isao-px/Abraxas_PCB/Fabrication/BOM_Abraxas_doable_2026-10-19.csv

ID | Name | Designator | Footprint | Quantity | Manufacturer Part | Manufacturer | Supplier | Supplier Part | Price | Pins | 3DModel | Contributor | JLCPCB Part Class | link
1 | 1kΩ | R1,R7,R33 | R0603 | 3 | FRC0603F1001TS | FOJAN(富捷) | LCSC | C2907002 | 0.002 | 2 | R0603 | lcsc | Extended Part | https://www.mouser.in/datasheet/2/447/PYu_RT_1_to_0_01_RoHS_L_11-1669912.pdf
2 | 220Ω | R2,R4,R5,R6,R13 | R0603 | 5 | FRC0603F2200TS | FOJAN(富捷) | LCSC | C2907014 | 0.002 | 2 | R0603 | lcsc | Extended Part | https://www.mouser.in/datasheet/2/447/PYu_RT_1_to_0_01_RoHS_L_11-1669912.pdf
3 | 510Ω | R9,R14 | R0603 | 2 | FRC0603F5100TS | FOJAN(富捷) | LCSC | C2907048 | 0.002 | 2 | R0603 | lcsc | Extended Part | https://www.mouser.in/datasheet/2/447/PYu_RT_1_to_0_01_RoHS_L_11-1669912.pdf
4 | 4.7kΩ | R10,R11 | R0603 | 2 | FRC0603F4701TS | FOJAN(富捷) | LCSC | C2907034 | 0.002 | 2 | R0603 | LCSC | Extended Part | https://www.mouser.in/datasheet/2/447/PYu_RT_1_to_0_01_RoHS_L_11-1669912.pdf
5 | 120Ω | R12 | R0603 | 1 | FRC0603F1200TS | FOJAN(富捷) | LCSC | C2906988 | 0.002 | 2 | R0603 | lcsc | Extended Part | https://www.mouser.in/datasheet/2/447/PYu_RT_1_to_0_01_RoHS_L_11-1669912.pdf
6 | KT-0603R | LED6,LED2,LED4,LED5,LED14,LED1,LED3 | LED-SMD_L1.6-W0.8-R-RD | 7 | KT-0603R | KENTO | LCSC | C2286 | 0.008 | 2 | LED0603_L1.6-W0.8-H0.6 | lcsc | Basic Part | https://item.szlcsc.com/347796.html
7 | 3.3kΩ | R8 | R0603 | 1 | FRC0603F3301TS | FOJAN(富捷) | LCSC | C2907023 | 0.002 | 2 | R0603 | lcsc | Extended Part | https://www.mouser.in/datasheet/2/447/PYu_RT_1_to_0_01_RoHS_L_11-1669912.pdf
8 | INFO_PINS | U15 | HDR-TH_8P-P2.54-V-F | 1 | BX-PM2.54-1-8PY | Bossie(博锡) | LCSC | C18078131 | 0.143 | 8 | HDR-TH_8P-P2.54-V-F | lcsc | Extended Part | https://item.szlcsc.com/760112.html
9 | KT-0603RG | LED13 | LED-SMD_4P-L1.6-W1.5_KT-0603RG | 1 | KT-0603RYG | KENTO | LCSC | C24477 | 0.027 | 4 | LED-ARRAY-SMD_4P-L1.6-W1.5-H0.6-P0.8 | lcsc | Extended Part | https://atta.szlcsc.com/upload/public/pdf/source/20240614/A37E0302B47AC53F7ED7BF75B5175F81.pdf
10 | NPN | Q11 | TO-92-3_L4.8-W3.7-P1.27-R-1 | 1 | BC547BBU | onsemi(安森美) | LCSC | C896669 | 0.155 | 3 | TO-92-3_L4.8-W3.7-P1.27-R-1 | LCSC | Extended Part | https://www.ti.com/cn/lit/ds/symlink/tlv431a.pdf?ts=1644846374370
11 | PNP | Q12 | TO-92-3_L4.9-W3.7-P1.27-L | 1 | BC557C | LGE(鲁光) | LCSC | C713618 | 0.048 | 3 | TO-92-3_L4.9-W3.7-P1.27-L | LCSC | Extended Part | https://atta.szlcsc.com/upload/public/pdf/source/20180629/C233232_99576441F8ED8E9074FB1575A6BE3592.PDF
12 | 51Ω | R35,R36 | R0603 | 2 | FRC0603F51R0TS | FOJAN(富捷) | LCSC | C2907050 | 0.002 | 2 | R0603 | LCSC | Extended Part | https://www.mouser.in/datasheet/2/447/PYu_RT_1_to_0_01_RoHS_L_11-1669912.pdf
13 | RS485/USB | U13 | HDR-TH_3P-P2.54-V-F | 1 | BX-PM2.54-1-3PY | Bossie(博锡) | LCSC | C18078126 | 0.095 | 3 | HDR2.54-F-LI-1X3P | lcsc | Extended Part | https://item.szlcsc.com/562471.html
14 | TS-1088-AR02016 | SW1,SW2 | SW-SMD_L3.9-W3.0-P4.45 | 2 | TS-1088-AR02016 | XUNPU(讯普) | LCSC | C720477 | 0.053 | 2 | SW-SMD_L3.9-W2.9-H2.0-LS4.8 | LCSC | Basic Part | https://item.szlcsc.com/457636.html
15 | 1.25A/2.5A | F1 | F1812 | 1 | MINISMDC125F/16-2 | Littelfuse(美国力特) | LCSC | C15156 | 0.309 | 2 | F1812_L4.5-W3.2-H1.0 | LCSC | Extended Part | https://item.szlcsc.com/343302.html
16 | SS12D10G5 | U12,U14,U11 | SW-TH_SHOU-HAN_SS12D10G4 | 3 | SS12D10G5 | SHOU HAN(首韩) | LCSC | C7431054 | 0.177 | 3 | SW-TH_SHOU-HAN_SS12D10G4 | lcsc | Extended Part | https://atta.szlcsc.com/upload/public/pdf/source/20210820/80D1704BBF3FCEE0435FCAA54C61E0A3.pdf
17 | 1000uF | C1 | CAP-TH_BD8.0-P3.50-D0.6-FD | 1 | ULR108M1AF1ACB | MAN YUE(万裕科技) | LCSC | C248439 | 0.251 | 2 | CAP-TH_D8.0-H8.0-P3.50 | LCSC | Extended Part | https://atta.szlcsc.com/upload/public/pdf/source/20151029/1457707523808.pdf
18 | SHIM1 | U8 | HDR-TH_12P-P2.54-V-F-R2-C6-S2.54 | 1 | BX-PM2.54-2-6PY | Bossie(博锡) | LCSC | C18078145 | 0.184 | 12 | HDR-TH_12P-P2.54-F-LI-2X6P | lcsc | Extended Part | https://item.szlcsc.com/562476.html
19 | SHIM2 | U9 | HDR-TH_2P-P2.54-V-F-1 | 1 | BX-PM2.54-1-2PY | Bossie(博锡) | LCSC | C18078125 | 0.095 | 2 | HDR2.54-F-LI-1X2P | lcsc | Extended Part | https://item.szlcsc.com/225782.html
20 | PB- | U7 | HDR-TH_2P-P2.54-V-F-1 | 1 | BX-PM2.54-1-2PY | Bossie(博锡) | LCSC | C18078125 | 0.095 | 2 | HDR2.54-F-LI-1X2P | lcsc | Extended Part | https://item.szlcsc.com/225782.html
21 | PB+ | U10 | HDR-TH_2P-P2.54-V-F-1 | 1 | BX-PM2.54-1-2PY | Bossie(博锡) | LCSC | C18078125 | 0.095 | 2 | HDR2.54-F-LI-1X2P | lcsc | Extended Part | https://item.szlcsc.com/225782.html
22 | GPS | U4 | HDR-TH_9P-P2.54-V-F-4 | 1 | BX-PM2.54-1-9PY | Bossie(博锡) | LCSC | C49326044 | 0.221 | 9 | HDR-TH_9P-P2.54-V-F-4 | lcsc | Extended Part | https://multimedia.3m.com/mws/media/22500O/3mtm-boardmount-skt-100-100x-100strt-sldr-tails-ts0815.pdf
23 | IMU | U5 | HDR-TH_5P-P2.54-V-F-B | 1 | BX-PM2.54-1-5PY | Bossie(博锡) | LCSC | C18078128 | 0.12 | 5 | HDR-TH_5P-P2.54-V-F-B | lcsc | Extended Part | https://atta.szlcsc.com/upload/public/pdf/source/20151109/1457707569826.pdf
24 | BX-PM2.54-2-20PY | U6 | HDR-TH_40P-P2.54-V-F-R2-C20-S2.54 | 1 | BX-PM2.54-2-20PY | Bossie(博锡) | LCSC | C18078157 | 0.428 | 40 | HDR-TH_40P-P2.54-F-LI-2X20P | lcsc | Extended Part | https://item.szlcsc.com/2776437.html?ref=editor&logined=true
25 | DB141R-2.54-10P | CN2 | CONN-TH_10P-P2.54_DIBO_DB141R-2.54-10P | 1 | DB141R-2.54-10P-GN | DORABO(地博电气) | LCSC | C2898762 | 0.926 | 20 | CONN-TH_10P-P2.54_DIBO_DB141R-2.54-10P | LCSC | Extended Part | https://atta.szlcsc.com/upload/public/pdf/source/20210923/647BDCE80A2FFB1C4BA209284C2F622C.pdf
