isao-px/Abraxas_PCB/PCB_Abraxas_doable_2026-10-19.dxf

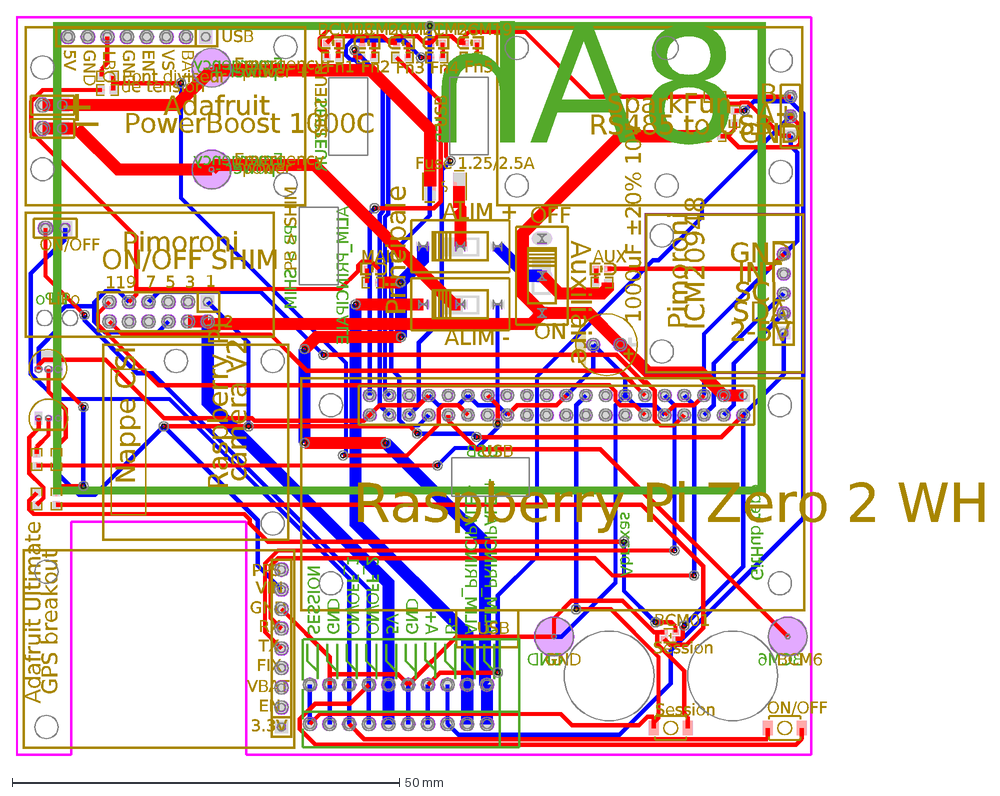
[picture p2: CAD file, 2026-10-19]
PCB_Abraxas_doable_2026-10-19.dxf
PB > SHIM
SECTEUR
LiPo
GND
BCM6
SESSION
ON/OFF_1
ON/OFF_2
5V
A+
B-
ALIM_PRINCIPALE -
ALIM_PRINCIPALE +
ALIM_PRINCIPALE
GitHub repo
Abraxas
8Ah
USB
Emergency
power +
power -
Adafruit Ultimate
GPS breakout
Pimoroni
ICM20948
Raspberry Pi Zero 2 WH
Raspberry Pi
INT
SCL
SDA
2-5V
3.3V
Adafruit
PowerBoost 1000C
+
_
Nappe CSI
camera V2
ON/OFF SHIM
Principale
Auxiliaire
OFF
ON
Fuse 1.25/2.5A
1000uF ±20% 10V
ALIM +
ALIM -
Session
ON/OFF
AUX
MAIN
SparkFun
RS485 to USB
EN
VBAT
FIX
TX
RX
VIN
PPS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
