isao-px/Abraxas_PCB/(list of files, drawings)

Other design files:
Full_components_doable_2026-10-19.schdoc
PCB_Abraxas_doable_2026-10-19.pcbdoc
PCB_PCB_Abraxas_doable_2026-10-19.json
SCH_Abraxas_doable_2026-10-19.json
