isao-px/Abraxas_PCB/(commit log)

2026-10-20 Add README
    Describe the board, the repository files, the hosted modules, the power
    paths, the external wiring and how to order the board.
2026-10-20 Cleaning up
    Removed notes about prototype defects and design documentation.
